devramsean0/nixieclock/(commit log)

2025-10-05 LV power regulation & RP2040 core
    [nixieclock.kicad_pcb, nixieclock.kicad_sch, power.kicad_sch, rp2040.kicad_sch]
2025-10-08 High Voltage!
    [power.kicad_sch, rp2040.kicad_sch]
2025-10-11 Start working on nixie tube stuff
    [nixieclock.kicad_sch, tubes.kicad_sch]
